ojaskul/CapstoneProject/light_switch_electronics/ls_pcb.png

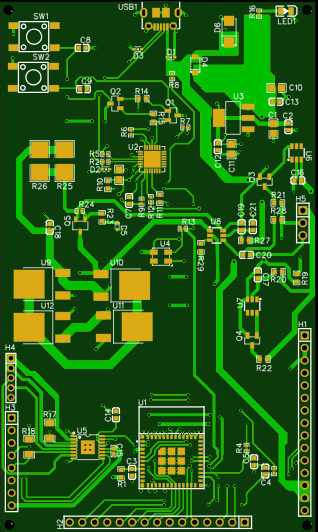
light_switch_electronics/ls_pcb.png
