ojaskul/CapstoneProject/schematics/ojas.png

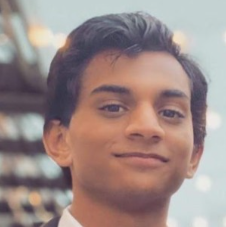
schematics/ojas.png
