ojaskul/CapstoneProject/demo_day_stuff.jpeg

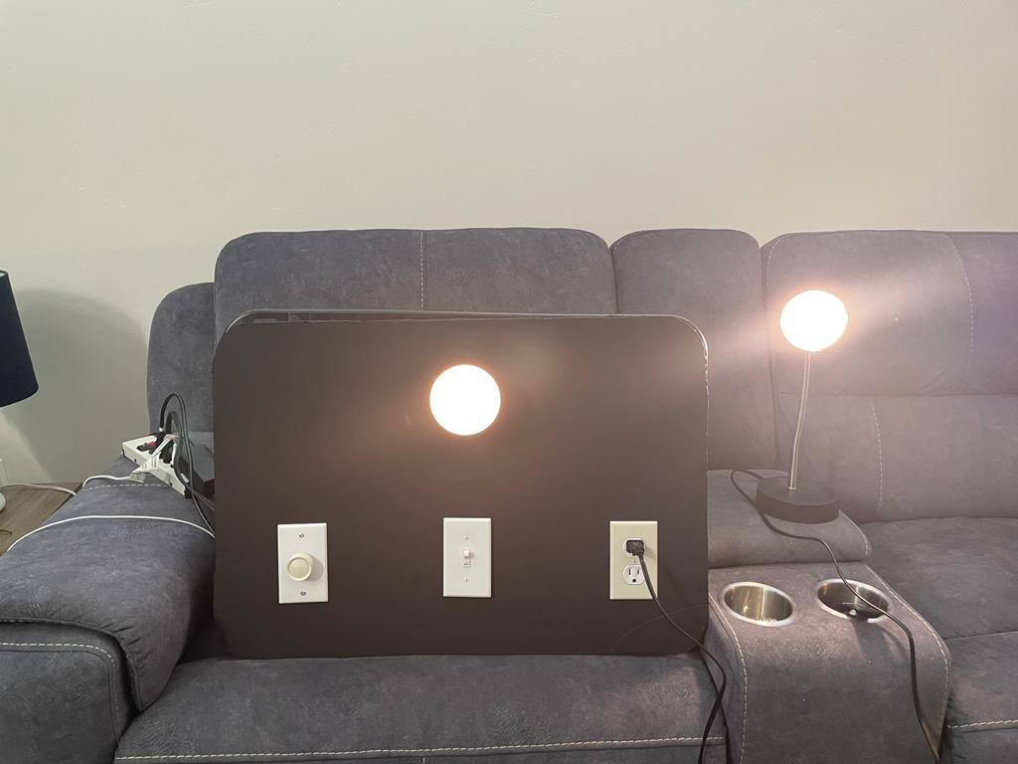
demo_day_stuff.jpeg
