ojaskul/CapstoneProject/light_switch_electronics/light_switch_final_layout.png

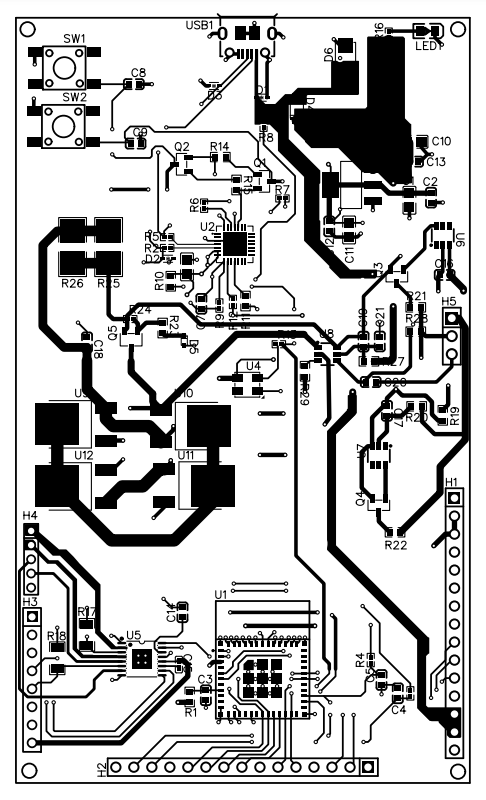
light_switch_electronics/light_switch_final_layout.png
