ojaskul/CapstoneProject/light_switch_electronics/light_switch_final_schem.png

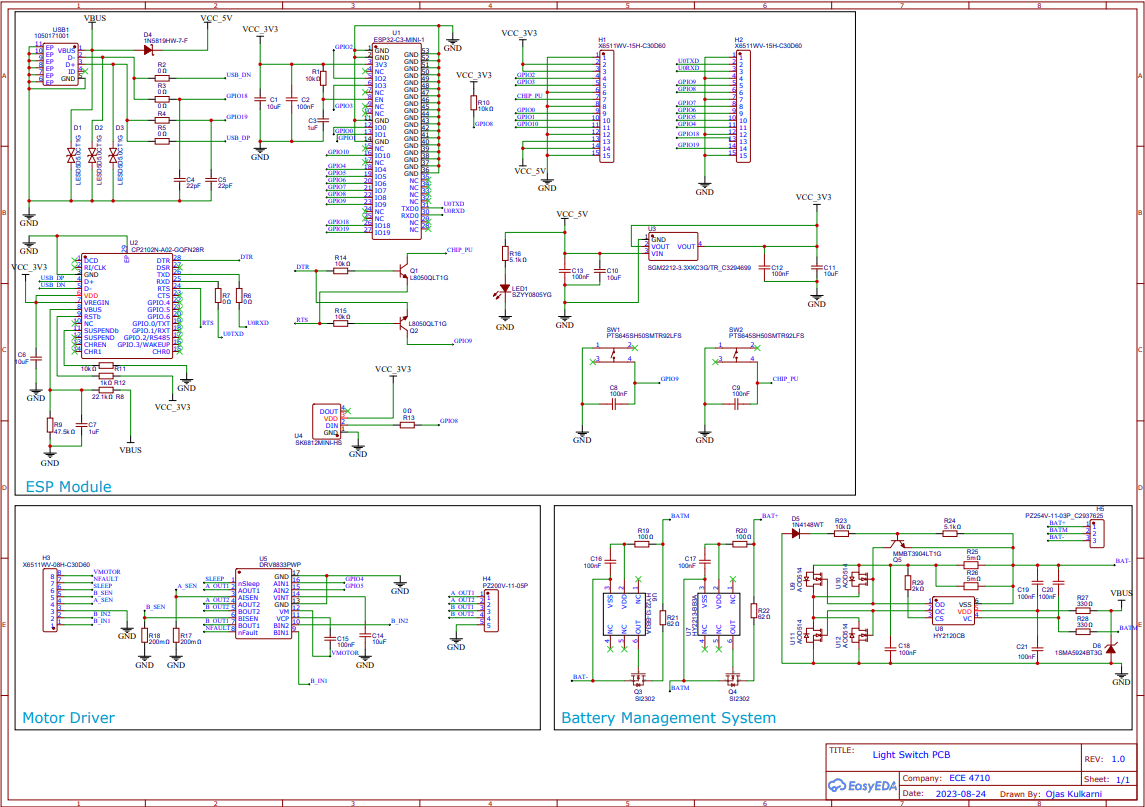
light_switch_electronics/light_switch_final_schem.png
