ojaskul/CapstoneProject/poster.png

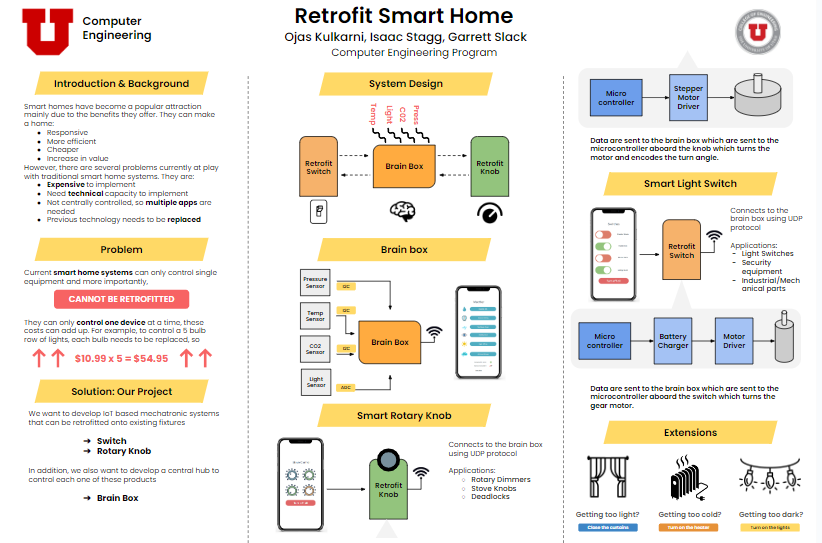
poster.png
