ojaskul/CapstoneProject/schematics/appdesign.png

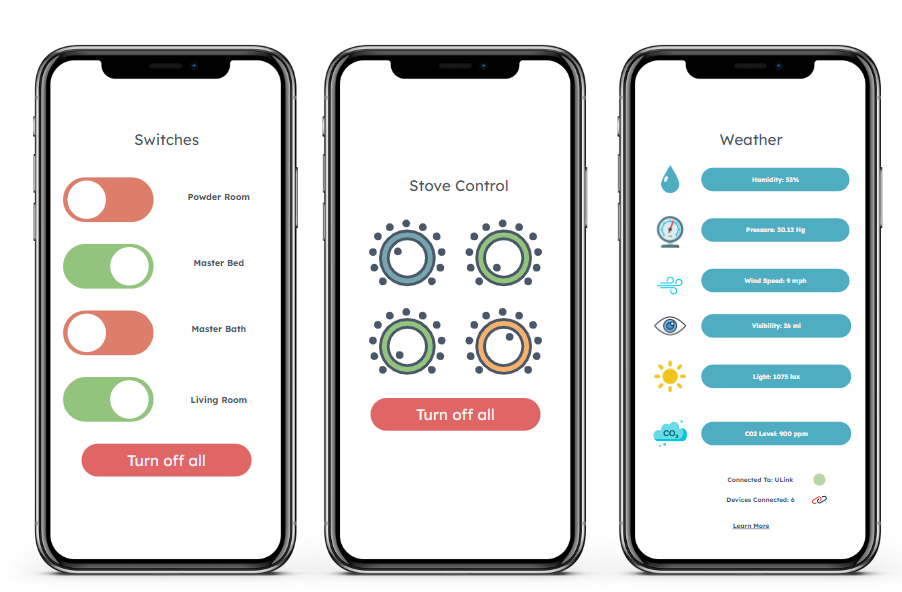
schematics/appdesign.png
