ojaskul/CapstoneProject/schematics/current_app.png

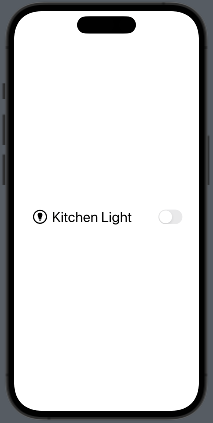
schematics/current_app.png
