ojaskul/CapstoneProject/schematics/garrett.jpg

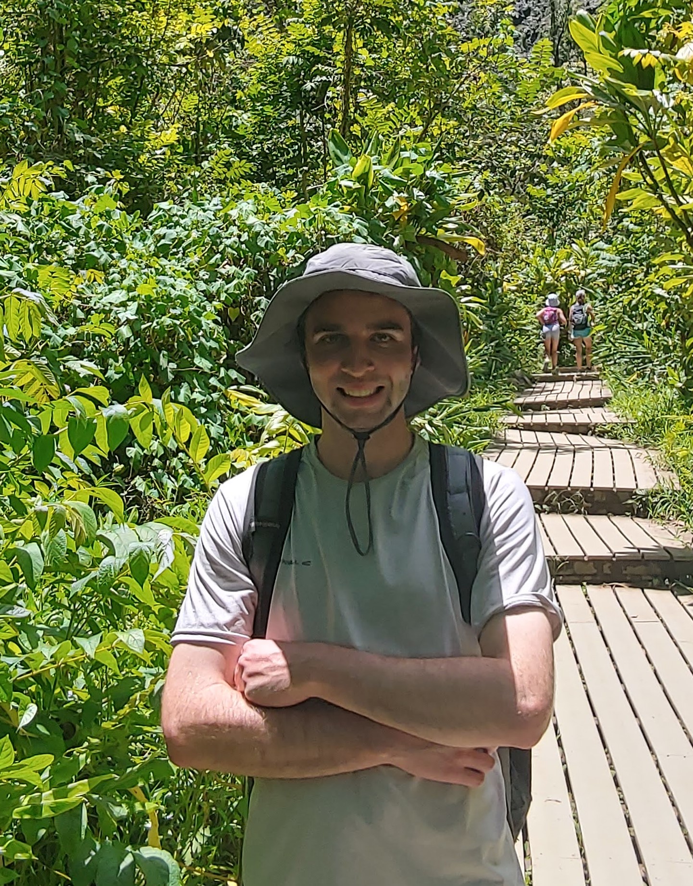
schematics/garrett.jpg
