ojaskul/CapstoneProject/schematics/lsbox.png

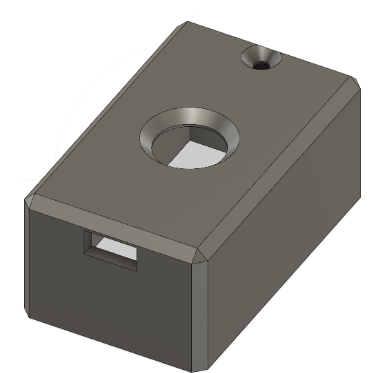
schematics/lsbox.png
