ojaskul/CapstoneProject/schematics/lspcb.png

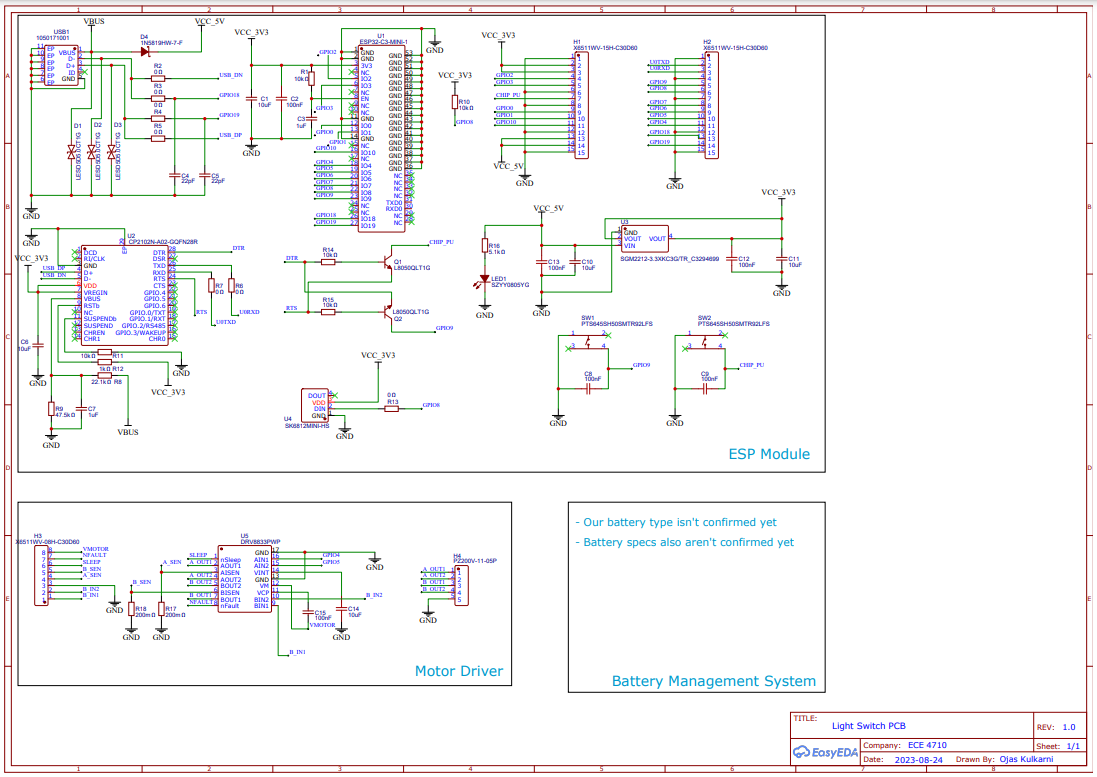
schematics/lspcb.png
