ojaskul/CapstoneProject/schematics/prototype_schem.png

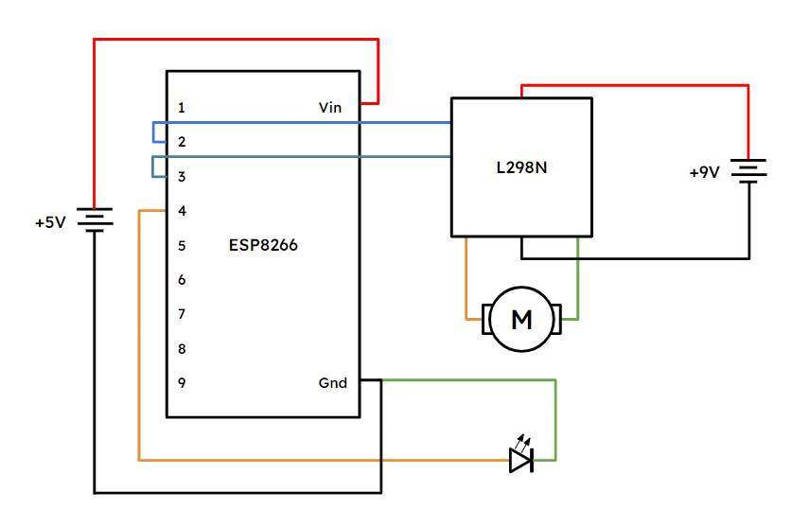
schematics/prototype_schem.png
