ojaskul/CapstoneProject/schematics/stovemockup.png

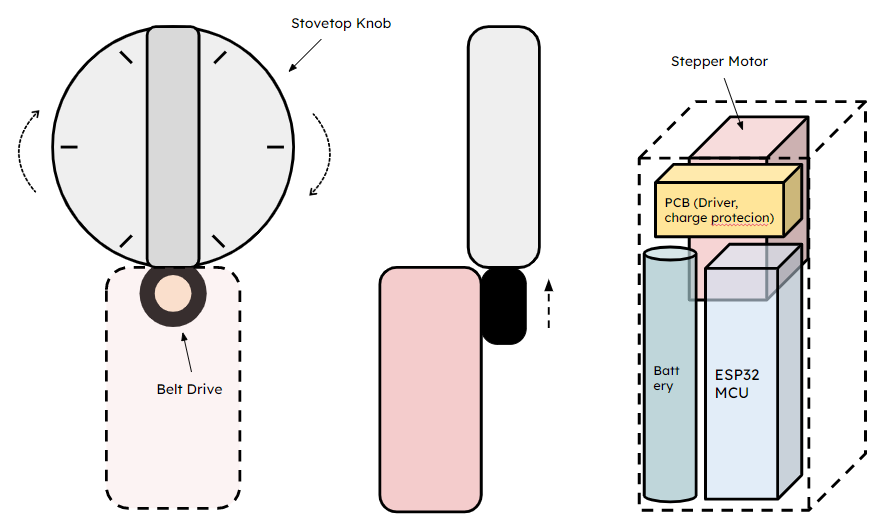
schematics/stovemockup.png
