ojaskul/CapstoneProject/schematics/switchmockup.png

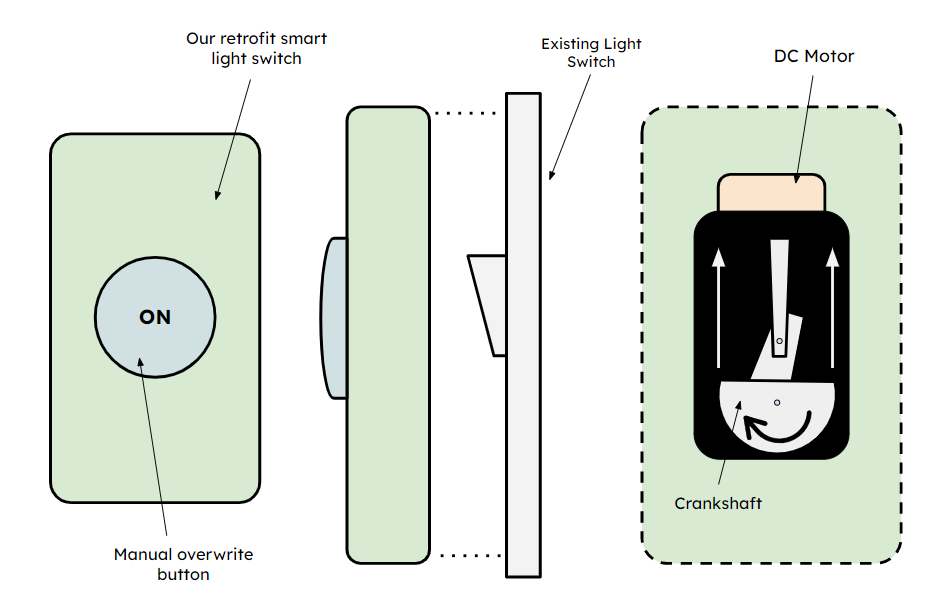
schematics/switchmockup.png
