ojaskul/CapstoneProject/schematics/weatherboxmockup.png

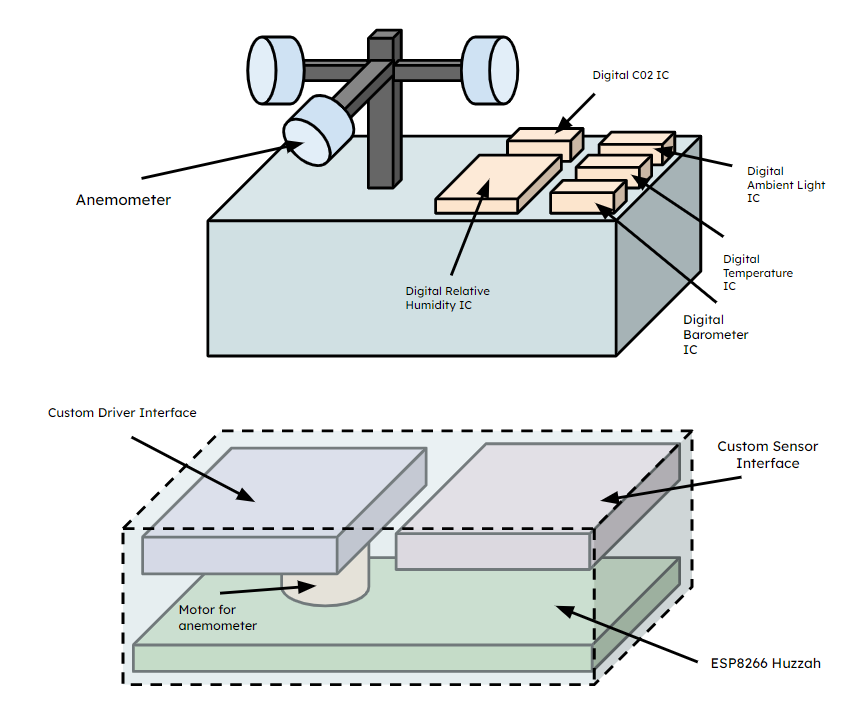
schematics/weatherboxmockup.png
