ojaskul/CapstoneProject/weather_box_electronics/weather_box_final_layout.png

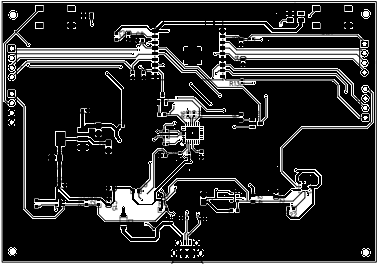
weather_box_electronics/weather_box_final_layout.png
