ojaskul/CapstoneProject/weather_box_electronics/weather_box_final_schem.png

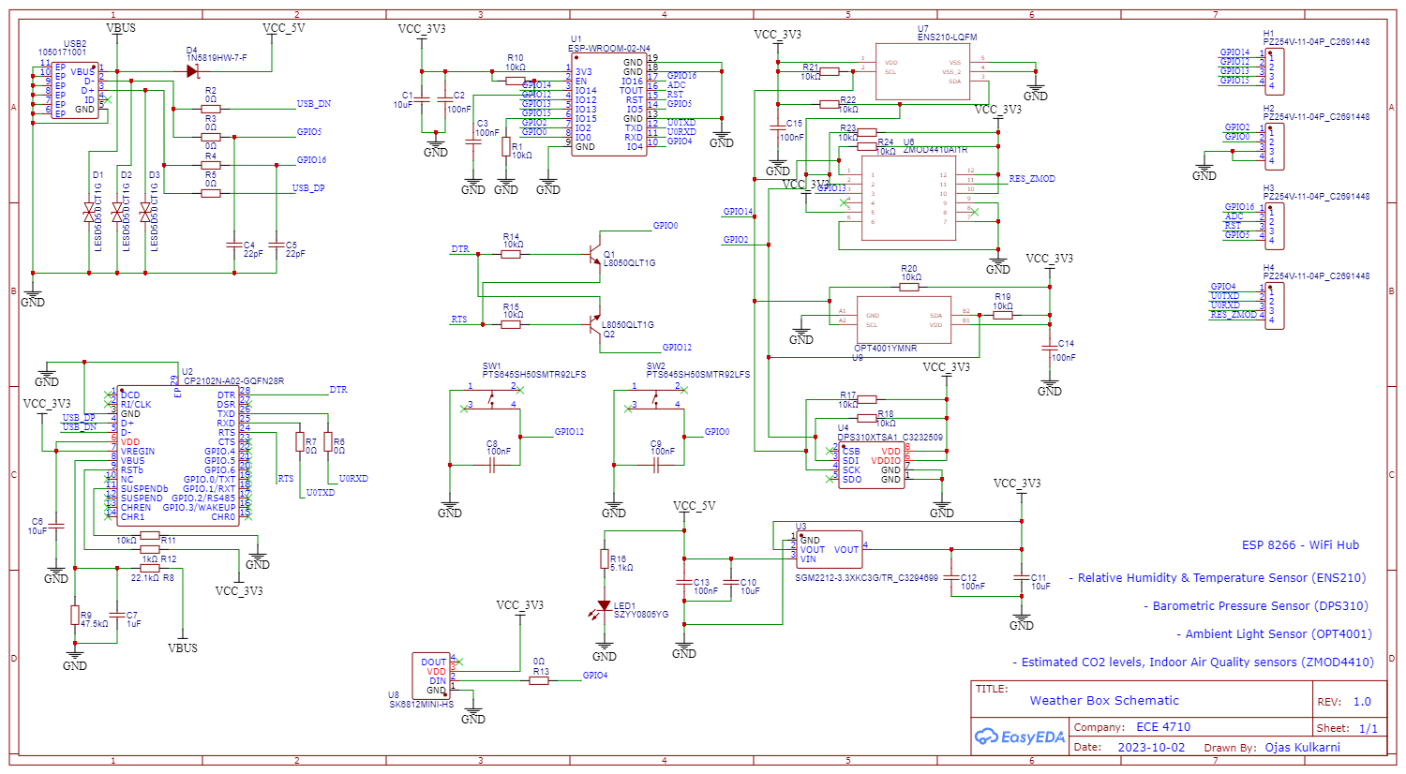
weather_box_electronics/weather_box_final_schem.png
