ojaskul/CapstoneProject/weather_box_electronics/weatherBoxPCB.png

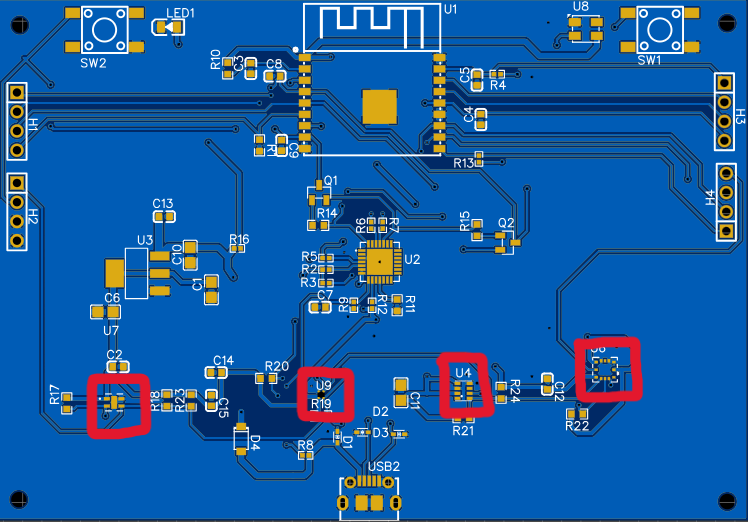
weather_box_electronics/weatherBoxPCB.png
