ojaskul/CapstoneProject/weather_box_electronics/weatherBoxBOM.xlsx

ID | Name | Designator | Footprint | Quantity | Manufacturer Part | Manufacturer | Supplier | Supplier Part | Price | Ordered
1 | 10uF | C1,C6,C10,C11 | C0805 | 4 | CL21A106KAYNNNE | SAMSUNG(三星) | LCSC | C15850 | 0.011 | Y
2 | 100nF | C2,C3,C8,C9,C12,C13,C14,C15 | C0603 | 8 | CL10B104KB8NNNC | SAMSUNG(三星) | LCSC | C1591 | 0.003 | Y
3 | 22pF | C4,C5 | C0603 | 2 | CL10C220JB8NNNC | SAMSUNG(三星) | LCSC | C1653 | 0.006 | Y
4 | 1uF | C7 | C0603 | 1 | CL10A105KO8NNNC | SAMSUNG(三星) | LCSC | C1592 | 0.003 | Y
5 | LESD5D5.0CT1G | D1,D2,D3 | SOD-523_L1.2-W0.8-LS1.6-BI | 3 | LESD5D5.0CT1G | LRC(乐山无线电) | LCSC | C383211 | 0.018 | Y
6 | 1N5819HW-7-F | D4 | SOD-123_L2.7-W1.6-LS3.7-RD | 1 | 1N5819HW-7-F | DIODES(美台) | LCSC | C82544 | 0.021 | Y
7 | PZ254V-11-04P_C2691448 | H1,H2,H3,H4 | HDR-TH_4P-P2.54-V-M | 4 | PZ254V-11-04P | XFCN(兴飞) | LCSC | C2691448 | 0.022 | Y
8 | SZYY0805YG | LED1 | LED0805-R-RD_GREEN | 1 | SZYY0805YG | yongyu(永裕光电) | LCSC | C434435 | 0.012 | Y
9 | L8050QLT1G | Q1,Q2 | SOT-23-3_L2.9-W1.3-P1.90-LS2.4-BR | 2 | L8050QLT1G | LRC(乐山无线电) | LCSC | C49581 | 0.012 | Y
10 | 10kΩ | R1,R10,R11,R14,R15,R17,R18,R19,R20,R21,R22,R23,R24 | R0603 | 13 | 0603WAF1002T5E | UNI-ROYAL(厚声) | LCSC | C25804 | 0.001 | Y
11 | 0Ω | R2,R3,R4,R5,R6,R7,R13 | R0402 | 7 | 0402WGF0000TCE | UNI-ROYAL(厚声) | LCSC | C17168 | 0.001 | Y
12 | 22.1kΩ | R8 | R0402 | 1 | 0402WGF2212TCE | UNI-ROYAL(厚声) | LCSC | C43473 | 0.001 | Y
13 | 47.5kΩ | R9 | R0402 | 1 | 0402WGF4752TCE | UNI-ROYAL(厚声) | LCSC | C25896 | 0.001 | Y
14 | 1kΩ | R12 | R0402 | 1 | 0402WGF1001TCE | UNI-ROYAL(厚声) | LCSC | C11702 | 0.001 | Y
15 | 5.1kΩ | R16 | R0402 | 1 | 0402WGF5101TCE | UNI-ROYAL(厚声) | LCSC | C25905 | 0.001 | Y
16 | PTS645SH50SMTR92LFS | SW1,SW2 | KEY-SMD_4P-L6.0-W6.0-P4.50-LS9.0 | 2 | PTS645SH50SMTR92LFS | C&K | LCSC | C221869 | 0.159 | Y
17 | ESP-WROOM-02-N4 | U1 | WIFIM-SMD_ESP-WROOM-02 | 1 | ESP-WROOM-02-N4 | ESPRESSIF(乐鑫) | LCSC | C2973671 | 1.799 | Y
18 | CP2102N-A02-GQFN28R | U2 | QFN-28_L5.0-W5.0-P0.50-TL-EP3.3 | 1 | CP2102N-A02-GQFN28R | SILICON LABS(芯科) | LCSC | C964632 | 2.393 | Y
19 | SGM2212-3.3XKC3G/TR_C3294699 | U3 | SOT-223-3_L6.5-W3.4-P2.30-LS7.0-BR | 1 | SGM2212-3.3XKC3G/TR | SGMICRO(圣邦微) | LCSC | C3294699 | 0.474 | Y
20 | DPS310XTSA1_C3232509 | U4 | LGA-8_DPS310XTSA1 | 1 | DPS310XTSA1 | Infineon(英飞凌) | LCSC | C3232509 | 1.332 | Y
21 | ZMOD4410AI1R | U6 | QFN_410AI1R_REN | 1 |  |  |  |  |  | Y
22 | ENS210-LQFM | U7 | SON-04-ENS210_2X2_AMS | 1 |  |  |  |  |  | Y
23 | SK6812MINI-HS | U8 | LED-SMD_4P-L3.5-W3.5-BR_SK6812MINI-HS | 1 | SK6812MINI-HS | 欧思科光电 | LCSC | C2922787 | 0.217 | Y
24 | OPT4001YMNR | U9 | PICOSTAR4_YMN_TEX | 1 |  |  |  |  |  | Y
25 | 1050171001 | USB2 | MICRO-USB-SMD_1050171001 | 1 | 1050171001 | MOLEX | LCSC | C505111 | 0.327 | Y
