ojaskul/CapstoneProject/light_switch_electronics/BOM_PCB_LightSwitchPCB_2023-09-21.csv

ID | Name | Designator | Footprint | Quantity | Manufacturer Part | Manufacturer | Supplier | Supplier Part | Price | Ordered
1 | 10uF | C1,C6,C10,C11 | C0805 | 4 | CL21A106KAYNNNE | SAMSUNG(三星) | LCSC | C15850 | 0.011 | Y
2 | 100nF | C2,C8,C9,C12,C13,C16,C17,C18,C19,C20,C21 | C0603 | 11 | CL10B104KB8NNNC | SAMSUNG(三星) | LCSC | C1591 | 0.002 | Y
3 | 1uF | C3,C7 | C0603 | 2 | CL10A105KO8NNNC | SAMSUNG(三星) | LCSC | C1592 | 0.003 | Y
4 | 22pF | C4,C5 | C0603 | 2 | CL10C220JB8NNNC | SAMSUNG(三星) | LCSC | C1653 | 0.007 | Y
5 | 10uF | C14 | C0603 | 1 | CL10A106KP8NNNC | SAMSUNG(三星) | LCSC | C19702 | 0.006 | Y
6 | 100nF | C15 | C0402 | 1 | CL05B104KO5NNNC | SAMSUNG(三星) | LCSC | C1525 | 0.001 | Y
7 | LESD5D5.0CT1G | D1,D2,D3 | SOD-523_L1.2-W0.8-LS1.6-BI | 3 | LESD5D5.0CT1G | LRC(乐山无线电) | LCSC | C383211 | 0.017 | Y
8 | 1N5819HW-7-F | D4 | SOD-123_L2.7-W1.6-LS3.7-RD | 1 | 1N5819HW-7-F | DIODES(美台) | LCSC | C82544 | 0.021 | Y
9 | 1N4148WT | D5 | SOD-523F_L1.2-W0.8-LS1.7-RD | 1 | 1N4148WT | Hottech(合科泰) | LCSC | C183892 | 0.013 | Y
10 | 1SMA5924BT3G | D6 | SMA_L4.3-W2.6-LS5.2-RD | 1 | 1SMA5924BT3G | onsemi(安森美) | LCSC | C50839 | 0.233 | Y
11 | X6511WV-15H-C30D60 | H1,H2 | HDR-TH_15P-P2.54-V-M | 2 | X6511WV-15H-C30D60 | XKB Connectivity(中国星坤) | LCSC | C725947 | 0.255 | Y
12 | X6511WV-08H-C30D60 | H3 | HDR-TH_8P-P2.54-V-M | 1 | X6511WV-08H-C30D60 | XKB Connectivity(中国星坤) | LCSC | C706880 | 0.115 | Y
13 | PZ200V-11-05P | H4 | HDR-TH_5P-P2.00-V-M | 1 | PZ200V-11-05P | XFCN(兴飞) | LCSC | C541859 | 0.025 | Y
14 | PZ254V-11-03P_C2937625 | H5 | HDR-TH_3P-P2.54-V-M | 1 | PZ254V-11-03P | XFCN(兴飞) | LCSC | C2937625 | 0.016 | Y
15 | SZYY0805YG | LED1 | LED0805-R-RD_GREEN | 1 | SZYY0805YG | yongyu(永裕光电) | LCSC | C434435 | 0.012 | Y
16 | L8050QLT1G | Q1,Q2 | SOT-23-3_L2.9-W1.3-P1.90-LS2.4-BR | 2 | L8050QLT1G | LRC(乐山无线电) | LCSC | C49581 | 0.012 | Y
17 | SI2302 | Q3,Q4 | SOT-23-3_L2.9-W1.3-P1.90-LS2.4-BR | 2 | SI2302 | Hottech(合科泰) | LCSC | C181087 | 0.027 | Y
18 | MMBT3904LT1G | Q5 | SOT-23-3_L2.9-W1.6-P1.90-LS2.8-BR | 1 | MMBT3904LT1G | onsemi(安森美) | LCSC | C81464 | 0.025 | Y
19 | 10kΩ | R1,R10,R11,R14,R15,R23 | R0603 | 6 | 0603WAF1002T5E | UNI-ROYAL(厚声) | LCSC | C25804 | 0.001 | Y
20 | 100Ω | R19,R20 | R0603 | 2 | 0603WAF1000T5E | UNI-ROYAL(厚声) | LCSC | C22775 | 0.001 | Y
21 | 62Ω | R21,R22 | R0603 | 2 | 0603WAF620JT5E | UNI-ROYAL(厚声) | LCSC | C23222 | 0.001 | Y
22 | 330Ω | R27,R28 | R0603 | 2 | 0603WAF3300T5E | UNI-ROYAL(厚声) | LCSC | C23138 | 0.001 | Y
23 | 2kΩ | R29 | R0603 | 1 | 0603WAF2001T5E | UNI-ROYAL(厚声) | LCSC | C22975 | 0.001 | Y
24 | 0Ω | R2,R3,R4,R5,R6,R7,R13 | R0402 | 7 | 0402WGF0000TCE | UNI-ROYAL(厚声) | LCSC | C17168 | 0.001
25 | 22.1kΩ | R8 | R0402 | 1 | 0402WGF2212TCE | UNI-ROYAL(厚声) | LCSC | C43473 | 0.001
26 | 47.5kΩ | R9 | R0402 | 1 | 0402WGF4752TCE | UNI-ROYAL(厚声) | LCSC | C25896 | 0.001 | Y
27 | 1kΩ | R12 | R0402 | 1 | 0402WGF1001TCE | UNI-ROYAL(厚声) | LCSC | C11702 | 0.001 | Y
28 | 5.1kΩ | R16,R24 | R0402 | 2 | 0402WGF5101TCE | UNI-ROYAL(厚声) | LCSC | C25905 | 0.001 | Y
29 | 200mΩ | R17,R18 | R1206 | 2 | 1206W4F200LT5E | UNI-ROYAL(厚声) | LCSC | C25335 | 0.005
30 | 5mΩ | R25,R26 | RES-SMD_L6.4-W3.2_C500733 | 2 | PA2512FKE070R005E | YAGEO(国巨) | LCSC | C914837 | 0.142 | Y
31 | PTS645SH50SMTR92LFS | SW1,SW2 | KEY-SMD_4P-L6.0-W6.0-P4.50-LS9.0 | 2 | PTS645SH50SMTR92LFS | C&K | LCSC | C221869 | 0.129 | Y
32 | CP2102N-A02-GQFN28R | U2 | QFN-28_L5.0-W5.0-P0.50-TL-EP3.3 | 1 | CP2102N-A02-GQFN28R | SILICON LABS(芯科) | LCSC | C964632 | 2.46 | Y
33 | SGM2212-3.3XKC3G/TR_C3294699 | U3 | SOT-223-3_L6.5-W3.4-P2.30-LS7.0-BR | 1 | SGM2212-3.3XKC3G/TR | SGMICRO(圣邦微) | LCSC | C3294699 | 0.474 | Y
34 | SK6812MINI-HS | U4 | LED-SMD_4P-L3.5-W3.5-BR_SK6812MINI-HS | 1 | SK6812MINI-HS | 欧思科光电 | LCSC | C2922787 | 0.198
35 | DRV8833PWP | U5 | TSSOP-16_L5.0-W4.4-P0.65-LS6.4-BL-EP | 1 | DRV8833PWPR | TI(德州仪器) | LCSC | C50506 | 0.802 | Y
36 | HY2213-BB3A | U6,U7 | SOT-23-6_L2.9-W1.6-P0.95-LS2.8-BR | 2 | HY2213-BB3A | HYCON(宏康) | LCSC | C113632 | 0.102
37 | HY2120CB | U8 | SOT-23-6_L2.9-W1.6-P0.95-LS2.8-BR | 1 | HY2120-CB | HYCON(宏康) | LCSC | C116509 | 0.202
38 | AOD514 | U9,U10,U11,U12 | TO-252-2_L6.6-W6.1-P4.57-LS9.9-BR-CW | 4 | AOD514 | Cmos(广东场效应半导体) | LCSC | C5203819
39 | 1050171001 | USB1 | MICRO-USB-SMD_1050171001 | 1 | 1050171001 | MOLEX | LCSC | C505111 | 0.327 | Y
40 | ESP32-C3-MINI-1 | U1 | WIFIM-SMD_ESP32-C3-MINI-1 | 1 | ESP32-C3-MINI-1 | RF Crazy(智汉) | LCSC | C5290152 |  | Y
