ojaskul/CapstoneProject/3d_prints/bbox_model.png

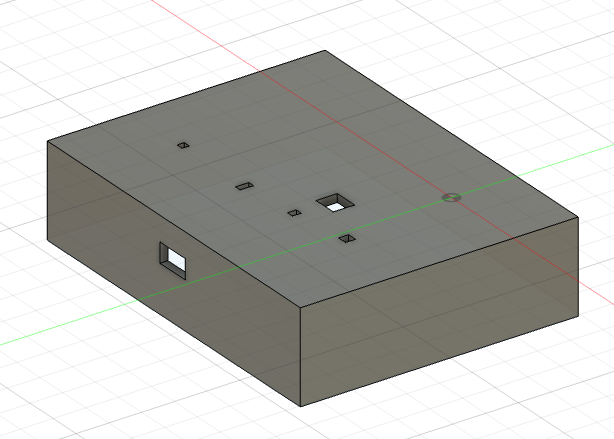
3d_prints/bbox_model.png
