ojaskul/CapstoneProject/3d_prints/dimmer_model.png

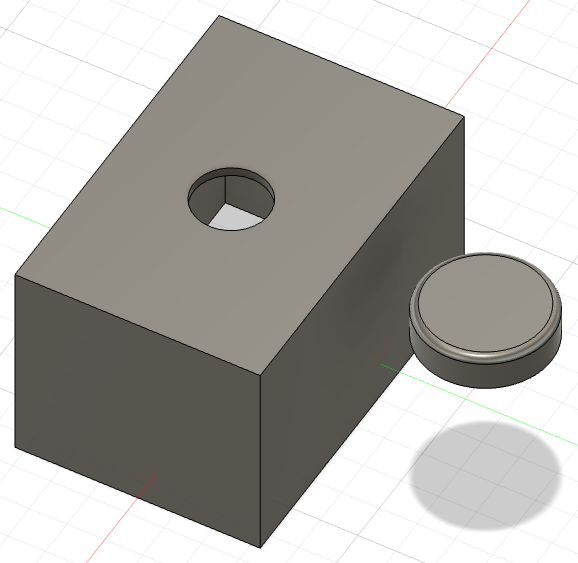
3d_prints/dimmer_model.png
