ojaskul/CapstoneProject/3d_prints/lightSwitchBoxFinal.png

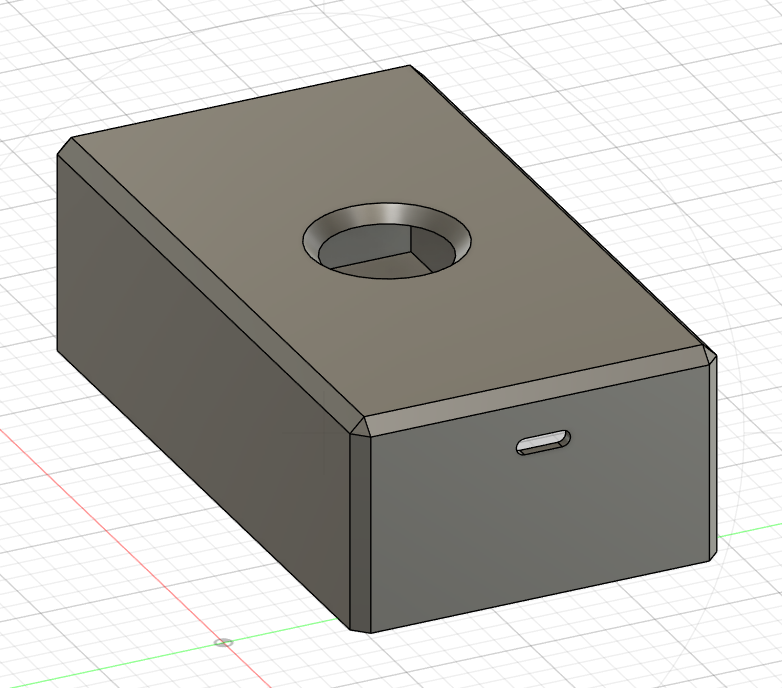
3d_prints/lightSwitchBoxFinal.png
