ojaskul/CapstoneProject/3d_prints/lightSwitchMechsFinal.png

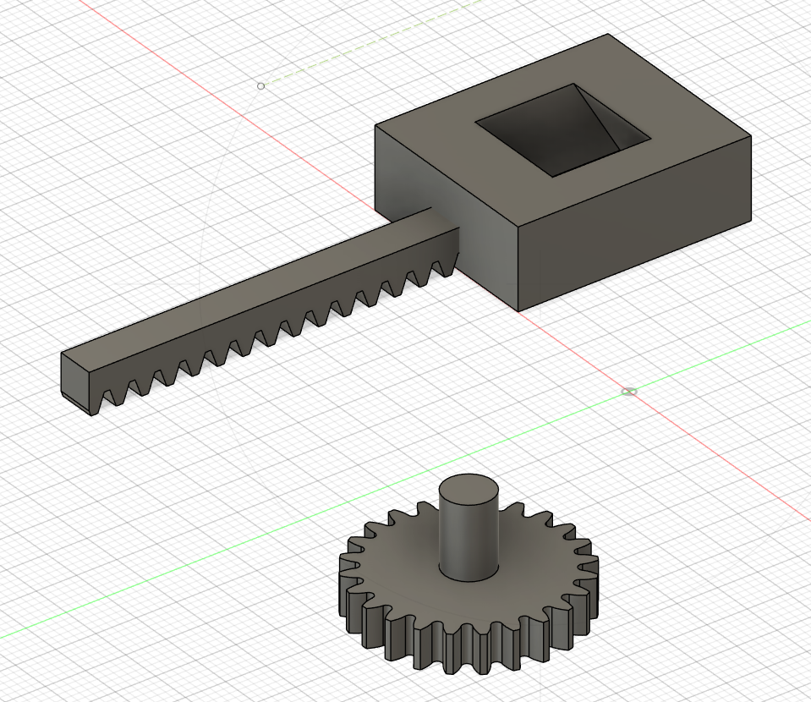
3d_prints/lightSwitchMechsFinal.png
