ojaskul/CapstoneProject/weather_box_electronics/weather_box_final_schem.pdf

# IO4 10 RXD 11 TXD 12 GND 13 IO5 14 RST 15 TOUT 16 IO16 17 GND 18 GND 19

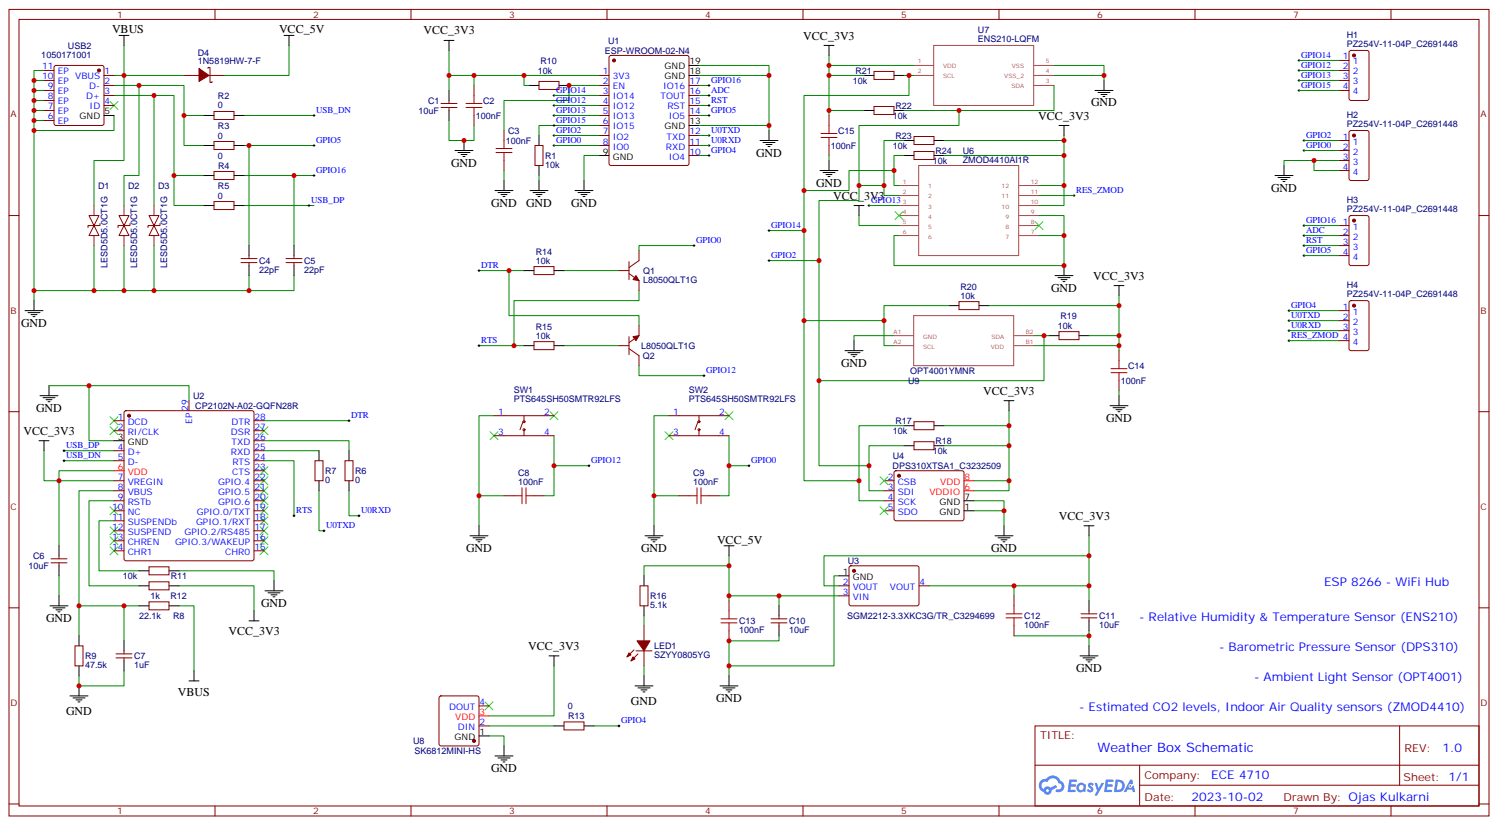
[picture p23: page 1]

- Relative Humidity & Temperature Sensor (ENS210)

- Estimated CO2 levels, Indoor Air Quality sensors (ZMOD4410)

Drawn By: Ojas Kulkarni
