ojaskul/CapstoneProject/light_switch_electronics/light_switch_final_schem.pdf

IO19 27 | NC 28 NC 29 RXD0 30 TXD0 31 NC 32 NC 33 NC 34 NC 35 GND 36 GND 37 GND 38 GND 39 GND 40 GND 41 GND 42 GND 43 GND 44 GND 45 GND 46 GND 47 GND 48 GND 49 GND 50 GND 51 GND 52 GND 53
CHR1 14 | CHR0 15 GPIO.3/WAKEUP 16 GPIO.2/RS485 17 GPIO.1/RXT 18 GPIO.0/TXT 19 GPIO.6 20 GPIO.5 21 GPIO.4 22 CTS 23 RTS 24 RXD 25 TXD 26 DSR 27 DTR 28 EP 29 LESD⁵D⁵.0CT1G

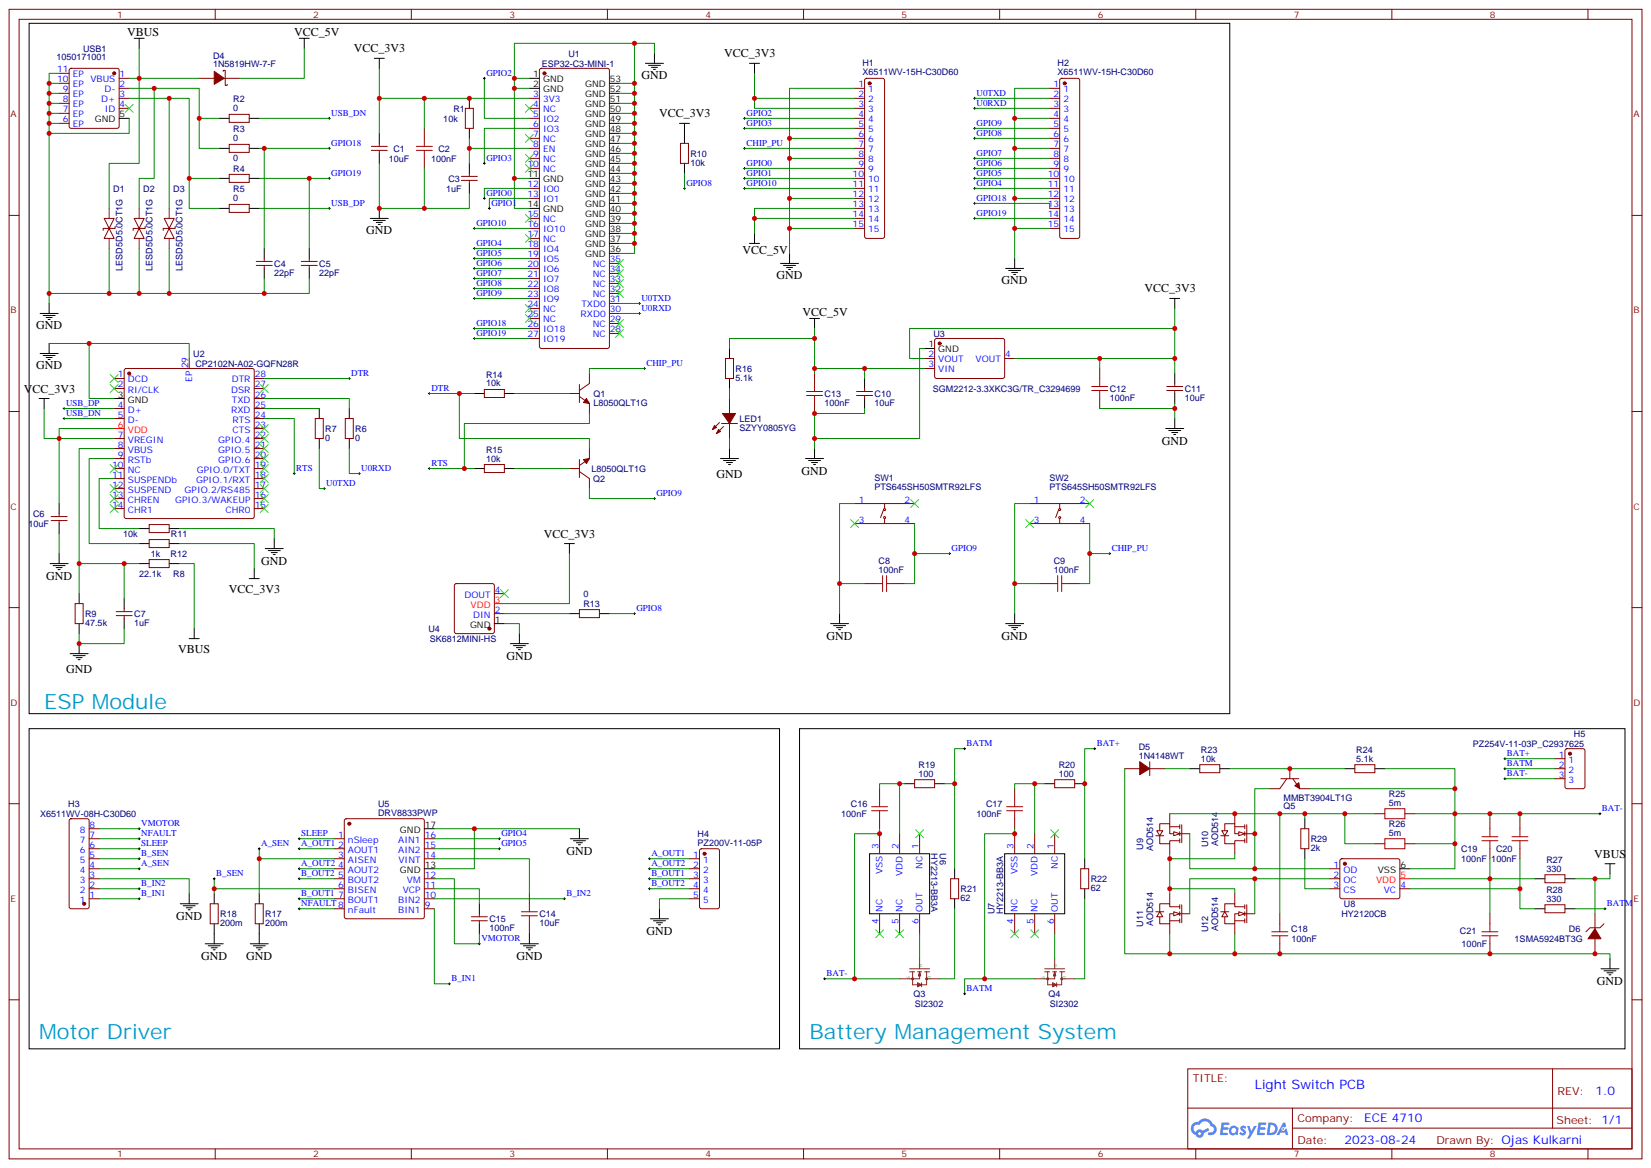
[picture p24: page 1]

Drawn By: Ojas Kulkarni
