ojaskul/CapstoneProject/weather_box_electronics/weather_box_final_layout.pdf

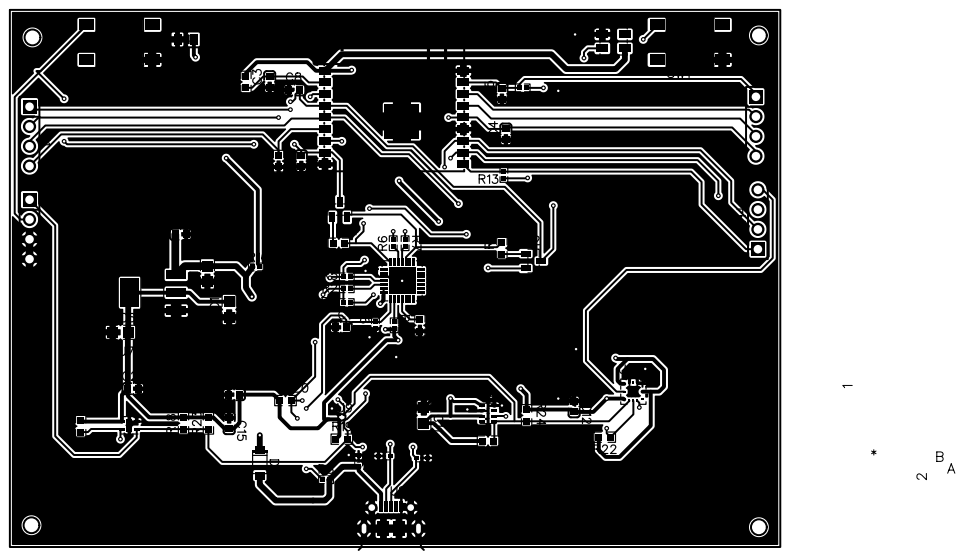
[picture p25: page 1]
