ojaskul/CapstoneProject/light_switch_electronics/light_switch_final_layout.pdf

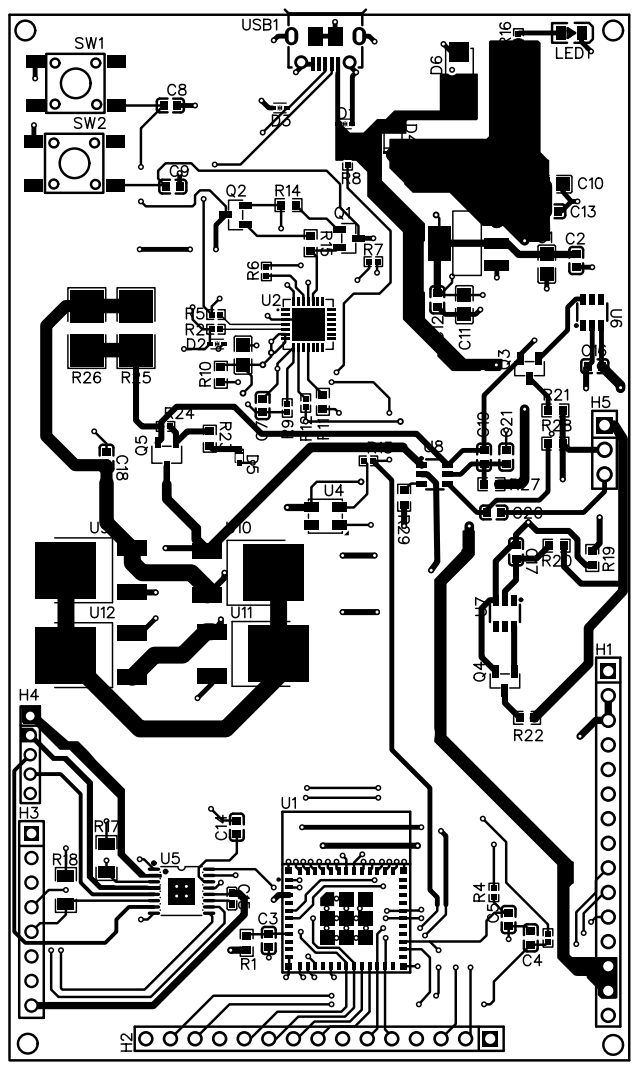
[picture p26: page 1]
