ojaskul/CapstoneProject/(commit log)

2023-04-25 prototype code
2023-04-27 Added schematics and refactored organization
2023-09-22 updated esp8266 code to model weather box layout. added code for esp32. updated app to support awaiting ack, and timeouts
2023-09-25 Added finalized light switch electronics, and updated web page
    [BOM_PCB_LightSwitchPCB_2023-09-21.csv, PickAndPlace_PCB_LightSwitchPCB_2023-09-21.csv]
2023-11-02 added gpio calls for motor
2023-11-04 Updated details and added progress images
    [weatherBoxBOM.xlsx]
2023-11-19 added code for stove knob and got stepper motors turning
